adafruit/Adafruit-3.2-TFT-Breakout-PCB/Adafruit 3.2in TFT 320x240.brd

## EAGLE design Adafruit 3.2in TFT 320x240.brd (2021-08-13)

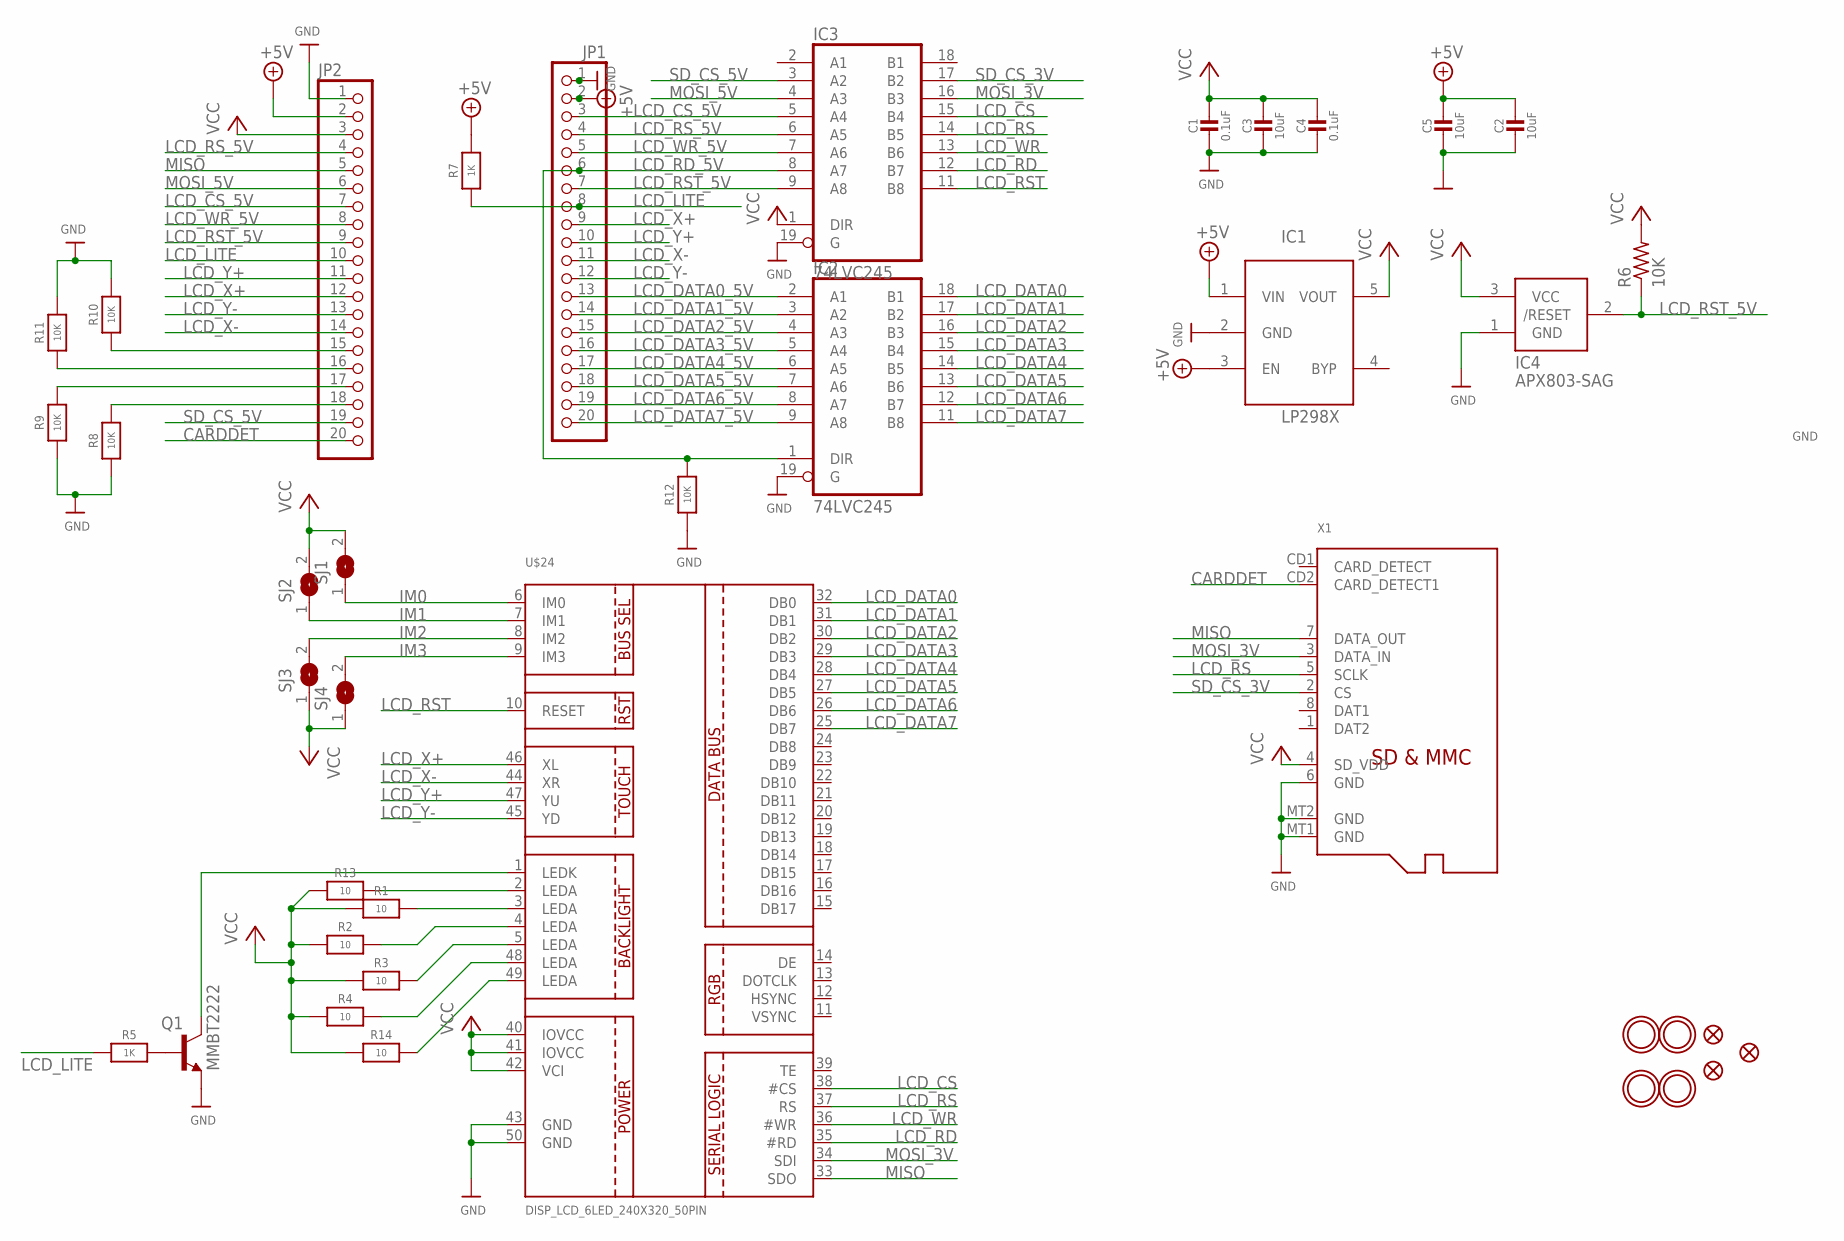
[picture p2: schematic Adafruit 3.2in TFT 320x240.sch]

Parts:
C1, C4: 0.1uF; 0805-NO
C2, C3, C5: 10uF; 0805-NO
IC1: APA2112-3.3; SOT23-5L
IC2, IC3: 74LVC245; SO20W
IC4: APX803-SAG; SOT23
JP1, JP2: HEADER-1X20ROUND; 1X20_ROUND
Q1: MMBT2222; SOT23-BEC
R1, R2, R3, R4, R13, R14: 10; 0805-NO
R5, R7: 1K; 0805-NO
R6: 10K; R0805
R8, R9, R10, R11, R12: 10K; 0805-NO
SJ1, SJ2, SJ3, SJ4: SOLDERJUMPER; SOLDERJUMPER_ARROW_NOPASTE
U$7, U$15, U$16, U$17: MOUNTINGHOLE3.0THIN; MOUNTINGHOLE_3.0_PLATEDTHIN
U$9, U$11, U$23: FIDUCIAL""; FIDUCIAL_1MM
U$24: DISP_LCD_6LED_240X320_50PIN; TFT_3.2IN_240X320_50PIN
X1: MICROSD

Connections:
+5V: C2.1, C5.1, IC1.1 (VIN), IC1.3 (EN), JP1.2, JP2.2, R7.2
CARDDET: JP2.20, X1.CD2 (CARD_DETECT1)
GND: C1.2, C2.2, C3.2, C4.2, C5.2, IC1.2 (GND), IC2.10 (GND), IC2.19 (G), IC3.10 (GND), IC3.19 (G), IC4.1 (GND), JP1.1, JP2.1, Q1.E, R8.1, R9.1, R10.2, R11.2, R12.1, U$24.43 (GND), U$24.50 (GND), X1.6 (GND), X1.MT1 (GND), X1.MT2 (GND)
IM0: JP2.18, R8.2, SJ1.1, U$24.6 (IM0)
IM1: JP2.17, R9.2, SJ2.1, U$24.7 (IM1)
IM2: JP2.16, R11.1, SJ3.2, U$24.8 (IM2)
IM3: JP2.15, R10.1, SJ4.2, U$24.9 (IM3)
LCD_CS: IC3.15 (B4), U$24.38 (#CS)
LCD_CS_5V: IC3.5 (A4), JP1.3, JP2.7
LCD_DATA0: IC2.18 (B1), U$24.32 (DB0)
LCD_DATA0_5V: IC2.2 (A1), JP1.13
LCD_DATA1: IC2.17 (B2), U$24.31 (DB1)
LCD_DATA1_5V: IC2.3 (A2), JP1.14
LCD_DATA2: IC2.16 (B3), U$24.30 (DB2)
LCD_DATA2_5V: IC2.4 (A3), JP1.15
LCD_DATA3: IC2.15 (B4), U$24.29 (DB3)
LCD_DATA3_5V: IC2.5 (A4), JP1.16
LCD_DATA4: IC2.14 (B5), U$24.28 (DB4)
LCD_DATA4_5V: IC2.6 (A5), JP1.17
LCD_DATA5: IC2.13 (B6), U$24.27 (DB5)
LCD_DATA5_5V: IC2.7 (A6), JP1.18
LCD_DATA6: IC2.12 (B7), U$24.26 (DB6)
LCD_DATA6_5V: IC2.8 (A7), JP1.19
LCD_DATA7: IC2.11 (B8), U$24.25 (DB7)
LCD_DATA7_5V: IC2.9 (A8), JP1.20
LCD_LITE: JP1.8, JP2.10, R5.1, R7.1
LCD_RD: IC3.12 (B7), U$24.35 (#RD)
LCD_RD_5V: IC2.1 (DIR), IC3.8 (A7), JP1.6, R12.2
LCD_RS: IC3.14 (B5), U$24.37 (RS), X1.5 (SCLK)
LCD_RST: IC3.11 (B8), U$24.10 (RESET)
LCD_RST_5V: IC3.9 (A8), IC4.2 (/RESET), JP1.7, JP2.9, R6.1
LCD_RS_5V: IC3.6 (A5), JP1.4, JP2.4
LCD_WR: IC3.13 (B6), U$24.36 (#WR)
LCD_WR_5V: IC3.7 (A6), JP1.5, JP2.8
LCD_X+: JP1.9, JP2.12, U$24.46 (XL)
LCD_X-: JP1.11, JP2.14, U$24.44 (XR)
LCD_Y+: JP1.10, JP2.11, U$24.47 (YU)
LCD_Y-: JP1.12, JP2.13, U$24.45 (YD)
MISO: JP2.5, U$24.33 (SDO), X1.7 (DATA_OUT)
MOSI_3V: IC3.16 (B3), U$24.34 (SDI), X1.3 (DATA_IN)
MOSI_5V: IC3.4 (A3), JP2.6
unnamed: R4.2, U$24.48 (LEDA)
unnamed: R1.2, U$24.3 (LEDA)
unnamed: R2.2, U$24.4 (LEDA)
unnamed: R3.2, U$24.5 (LEDA)
unnamed: Q1.C, U$24.1 (LEDK)
unnamed: R14.2, U$24.49 (LEDA)
unnamed: R13.2, U$24.2 (LEDA)
unnamed: Q1.B, R5.2
SD_CS_3V: IC3.17 (B2), X1.2 (CS)
SD_CS_5V: IC3.3 (A2), JP2.19
VCC: C1.1, C3.1, C4.1, IC1.5 (VOUT), IC2.20 (VCC), IC3.1 (DIR), IC3.20 (VCC), IC4.3 (VCC), JP2.3, R1.1, R2.1, R3.1, R4.1, R6.2, R13.1, R14.1, SJ1.2, SJ2.2, SJ3.1, SJ4.1, U$24.40 (IOVCC), U$24.41 (IOVCC), U$24.42 (VCI), X1.4 (SD_VDD)

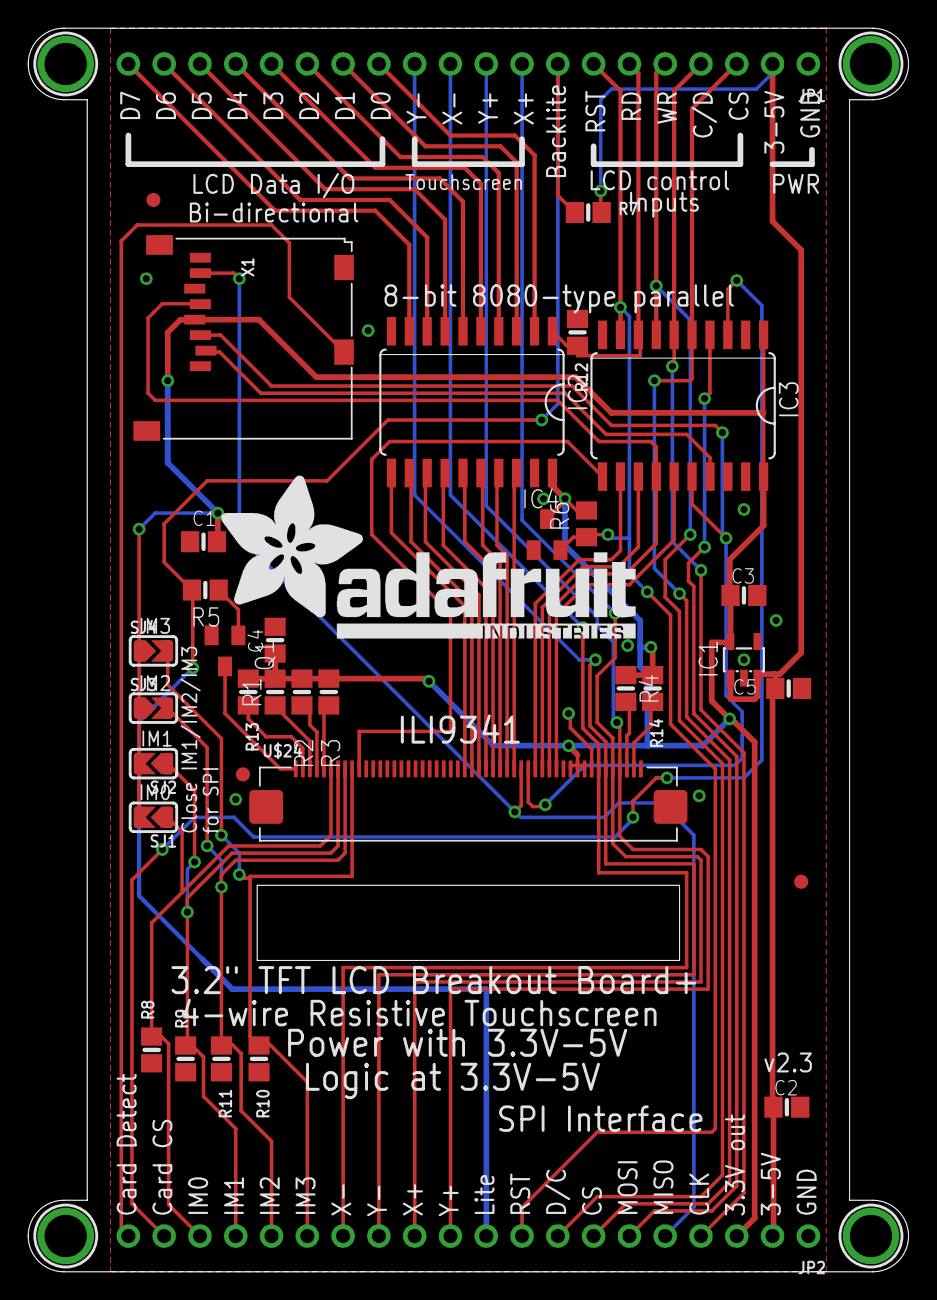
[picture p3: board Adafruit 3.2in TFT 320x240.brd from above]

Board: 2 copper layers, 62.5 x 88.3 mm, 40 parts (1 on the bottom side), 52 nets.

Other parts of the board:
U$19: ADAFRUIT_TEXT_30MM
