adafruit/Adafruit-3.2-TFT-Breakout-PCB/(commit log)

2021-08-13 Rename Adafruit 3.2in 320x240.brd to Adafruit 3.2in TFT 320x240.brd
    [Adafruit 3.2in TFT 320x240.brd]
2021-08-13 Rename Adafruit 3.2in 320x240.sch to Adafruit 3.2in TFT 320x240.sch
    [Adafruit 3.2in TFT 320x240.sch]
